Ushinbuy/PHD_Badge_2025/README.md

# PHD_Badge_2025
This repository contain hardware files of PHD Badge 2025
