Ushinbuy/PHD_Badge_2025/pcb/BOM/Bill of Materials-PHD_Badge_revС(Production).xlsx

Designator | Description/Value | PartNumber | Package | Quantity | Notes
A1 | Bluetooth, WiFi 802.11b/g/n Transceiver Module 2.4GHz PCB antenna SMD module | ESP32-WROOM-32E-N16 | 38-SMD Module, Exposed Pad | 1 | Аналог ESP32-WROOM-32E-N16R2
C1_A2, C1_A3, C1_A4, C1_A5, C1_A6, C1_A7, C1_A8, C1_A9, C1_A10, C1_A11, C2_A2, C2_A3, C2_A4, C2_A5, C2_A6, C2_A7, C2_A8, C2_A9, C2_A10, C2_A11, C15, C26 | Ceramic capacitor, 0805, 1u, ±10%, 25V, X7R, -55...+125°C, Capacitors SMD 0805, 1 uF, 25V, X7R, 0805 | CC0805KFX7R8BB105 | 0805 | 22
C11, C12, C14, C19, C21, C22, C29, C30, C31, C32, C33 | Capacitors SMD 0805, 100 nF, 50V, X7R, 0805, Ceramic capacitor, 0805, 0.1u, ±10%, 50V, X7R, -55...+125°C | CC0805JRX7R9BB104 | 0805 | 11
C13, C25 | Capacitors SMD 0805, 10 uF, 10V, X7R, 0805 | CC0805KKX7R6BB106 | 0805 | 2
C16 | Capacitors SMD 0805, 4.7 nF, 50V, NP0, 0805 | GRM2165C1H472JA01D | 0805 | 1
C17, C18, C23, C24, C27, C28 | Capacitors SMD 1206, 22 uF, 16V, X5R, 1206 | GRM31CR61C226KE15L | 1206 | 6
C20 | Capacitors SMD 0805, 470 pF, 50V, NP0, 0805 | CC0805JRNPO9BN471 | 0805 | 1
D1, D2 | DIODE, SCHOTTKY, 1A, 40V, SOD-123 | 1N5819HW | SOD-123 | 2
D3, D4 | Diode Schottky 40V 1A Surface Mount DO-214AC (SMA) | SS34 | DO-214AC (SMA) | 2
DA1 | 1A Standalone Linear Li-lon Battery Charger with Thermal | TP4056-42-SOP8-PP | eSOP-8 | 1
DA2 | 600mA CMOS L.D.O. Regulator | LM8805SF5-3.3 | SOT23-5 | 1
L1 | Power Inductors - SMD 22uH 2.9A 30% SMD LP | CDRH105RNP-220NC | SMD 10x10x5 | 1
LED1, LED2 | LED IR LED-SMD(3010) Right Angel | KPA-3010F3C | LED-SMD(3010), Right Angel | 2
Q1 | Electro-magnetic Sound Generator Component | HCS0905Z/1196 | HCS0905Z/1196 | 1
R1, R6, R7, R14, R29 | Resistors SMD 0805, 1 kOhm, 5%, 0805 | RC0805JR-071KL | 0805 | 5
R2, R5, R10 | Resistors SMD 0805, 1.2 kOhm, 1%, 0805 | RC0805FR-071K2L | 0805 | 3
R3 | Resistors SMD 1206, 0.2, ±1%, 1206 | RL1206FR-070R2L | 1206 | 1
R4, R22, R23, R24, R25, R26, R27, R28, R30 | Resistors SMD 0805, 10 kOhm, 5%, 0805 | RC0805JR-0710KL | 0805 | 9
R8, R9 | Resistors SMD 0805, 100 Ohm, 5%, 0805 | RC0805JR-07100RL | 0805 | 2
R12, R16 | Resistors SMD 0805, 5.1 kOhm, 1%, 0805 | RC0805FR-075K1L | 0805 | 2
R13, R17 | Resistors SMD 0805, 0 Ohm, 5%, 0805 | RC0805JR-070RL | 0805 | 2
R15 | Resistors SMD 0805, 1 MOhm, 5%, 0805 | RC0805JR-071ML | 0805 | 1
R18 | Resistor thick-film, 0805, 330k, ±1%, 0.063W, -55...+125°C | RC0805FR-07330KL | 0805 | 1
R19 | Resistor thick-film, 0805, 510k, ±1%, 0.063W, -55...+125°C | RC0805FR-07510KL | 0805 | 1
R20 | Resistors SMD 0805, 16 kOhm, 1%, 0805 | RC0805FR-0716KL | 0805 | 1
R21 | Resistors SMD 0805, 2.2 kOhm, 1%, 0805 | RC0805FR-072K2L | 0805 | 1
SW1 | Tactile Switch SPST-NO Top Actuated Surface Mount | MSK-12C02 | MSK-12C02 | 1
SW2, SW3, SW4 | SMT Button 3x6 Tact Switch Series | IT-1188E | IT-1188E SMD 6x3x3.5 | 3
U1 | IC 8BIT SHIFT REG 3ST-OUT 16SOIC | CH340C | 16-SOIC (0.154", 3.90mm Width) | 1
U2 | IR Remote Receiver 38 kHz 4-Pin | TSOP75238 | SMD 6.8x3.0x3.2 | 1
U3 | High Efficiency 1.2MHz 2A Step Up Converter | MT3608 | SOT23-6 | 1
VD1_A2, VD1_A3, VD1_A4, VD1_A5, VD1_A6, VD1_A7, VD1_A8, VD1_A9, VD1_A10, VD1_A11, VD2_A2, VD2_A3, VD2_A4, VD2_A5, VD2_A6, VD2_A7, VD2_A8, VD2_A9, VD2_A10, VD2_A11, VD3_A2, VD3_A3, VD3_A4, VD3_A5, VD3_A6, VD3_A7, VD3_A8, VD3_A9, VD3_A10, VD3_A11, VD4_A2, VD4_A3, VD4_A4, VD4_A5, VD4_A6, VD4_A7, VD4_A8, VD4_A9, VD4_A10, VD4_A11, VD5_A2, VD5_A3, VD5_A4, VD5_A5, VD5_A6, VD5_A7, VD5_A8, VD5_A9, VD5_A10, VD5_A11, VD6_A2, VD6_A3, VD6_A4, VD6_A5, VD6_A6, VD6_A7, VD6_A8, VD6_A9, VD6_A10, VD6_A11, VD7_A2, VD7_A3, VD7_A4, VD7_A5, VD7_A6, VD7_A7, VD7_A8, VD7_A9, VD7_A10, VD7_A11, VD8_A2, VD8_A3, VD8_A4, VD8_A5, VD8_A6, VD8_A7, VD8_A8, VD8_A9, VD8_A10, VD8_A11, VD9_A2, VD9_A3, VD9_A4, VD9_A5, VD9_A6, VD9_A7, VD9_A8, VD9_A9, VD9_A10, VD9_A11, VD10_A2, VD10_A3, VD10_A4, VD10_A5, VD10_A6, VD10_A7, VD10_A8, VD10_A9, VD10_A10, VD10_A11 | Top SMD Type 0.2Watt Power tegrated light source Intelligent control LED 3.5x3.7x0.95mm | WS2812B-Mini | LED 3535 | 100
VD11 | LED GREEN CLEAR 0603 SMD | KPA-3010CGCK | LED-SMD(3010), Right Angel | 1
VD12 | LED RED CLEAR 0603 SMD | KPA-3010SURC | LED-SMD(3010), Right Angel | 1
VT1, VT2, VT3, VT5, VT6 | MOSFET N-channel, SOT23 | BSS138 | SOT23-3 | 5
VT4 | MOSFET P-channel, SOT23 | AO3401 | SOT23-3 | 1
X1 | Li-Pol Accumulator, JST-PHR-03 plug,BR603448D-PCM-NTC-LD, size 50.5x34.5x6.2 | BR603448D-PCM-NTC-LD | 50.5x34.5x6.2 | 1
X6 | USB type-C connector | 1054500101 | 1054500101 | 1
X7 | A range shrouded headers for the JST PH series of low-profile 2.0mm pitch wire-to-board connectors. | S3B-PH-SM4-TB | JST PH, 2.0mm, 3 pin, THD | 1
