Ushinbuy/PHD_Badge_2025/3d/Front frame.stl

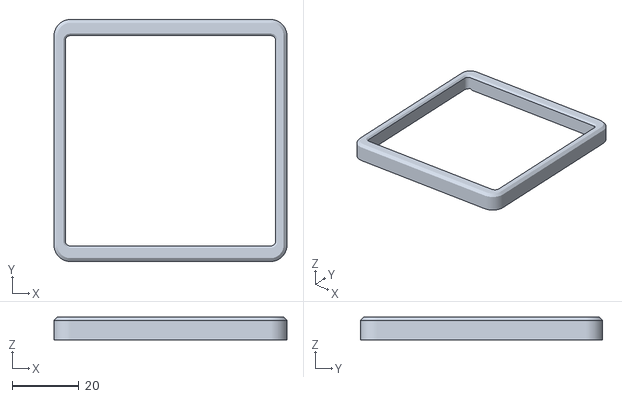
[picture p1: CAD file, 2025-04-30]
3d/Front frame.stl
70.0 x 72.8 x 6.84
