Ushinbuy/PHD_Badge_2025/3d/Thick FrameFrame.stl

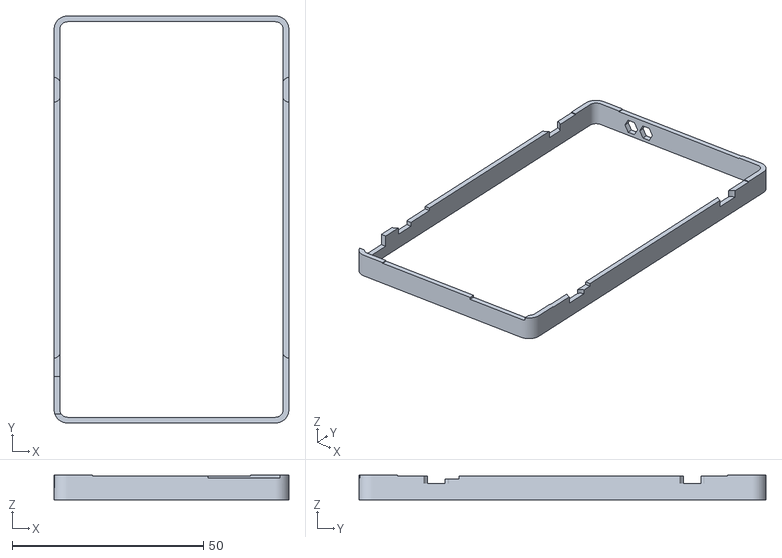
[picture p2: CAD file, 2025-04-30]
3d/Thick FrameFrame.stl
61.4 x 106.4 x 6.50
