Ushinbuy/PHD_Badge_2025/3d/Table_for_Leds.stl

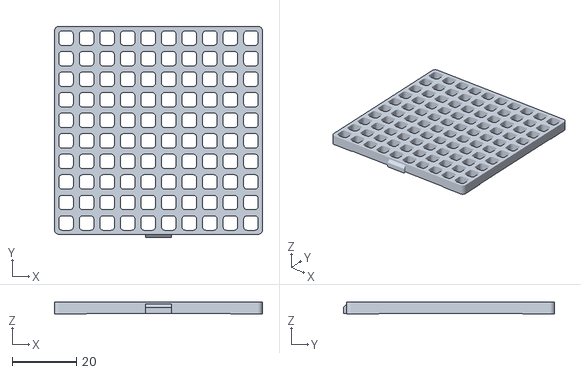
[picture p3: CAD file, 2025-04-30]
3d/Table_for_Leds.stl
64.8 x 65.9 x 3.84
