Ushinbuy/PHD_Badge_2025/3d/Back Frame upd.stl

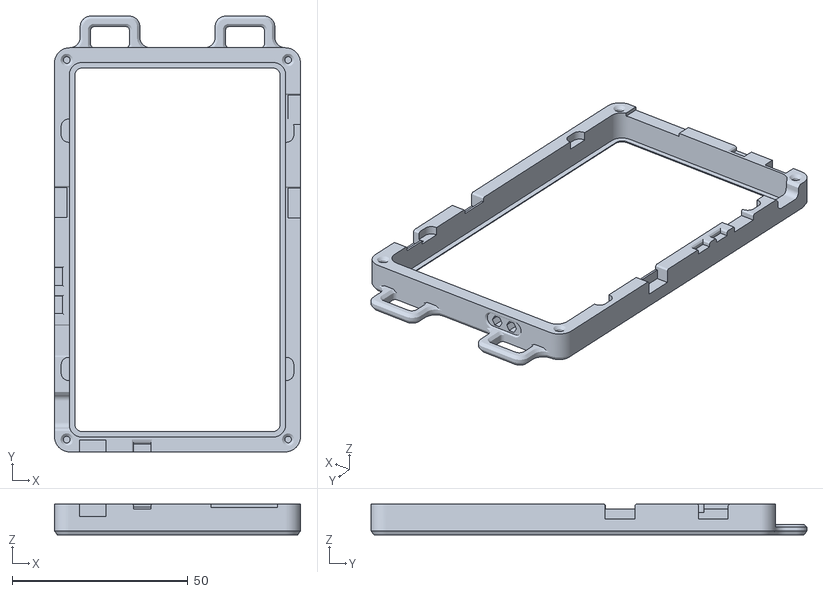
[picture p4: CAD file, 2025-04-30]
3d/Back Frame upd.stl
70.0 x 124.0 x 8.80
