Ushinbuy/PHD_Badge_2025/pcb/Schematic PDF/PHD_Badge_revС.PDF

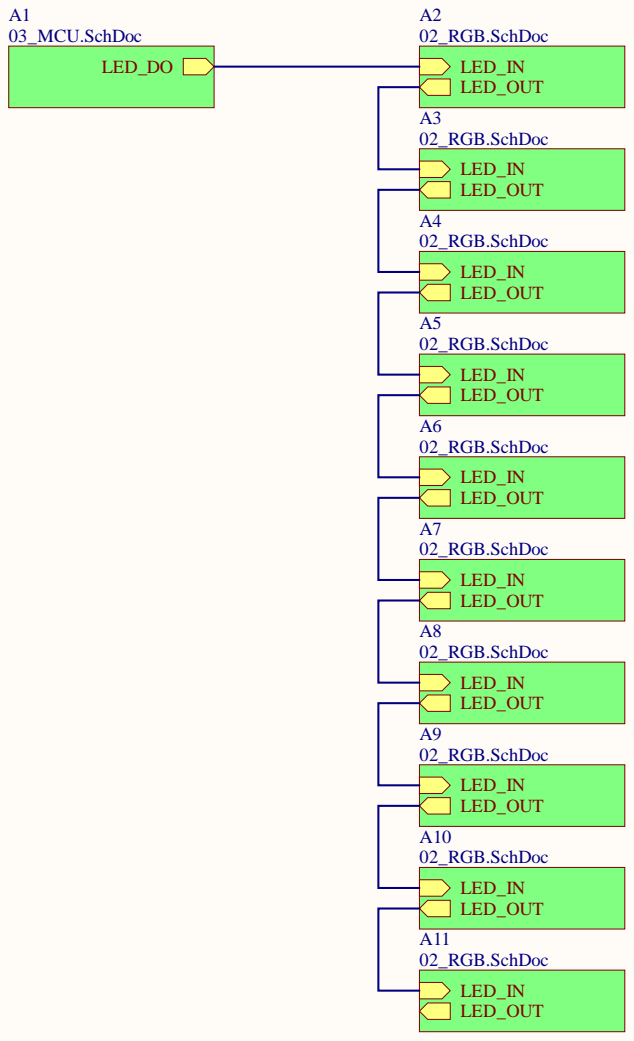
[picture p5: page 1]

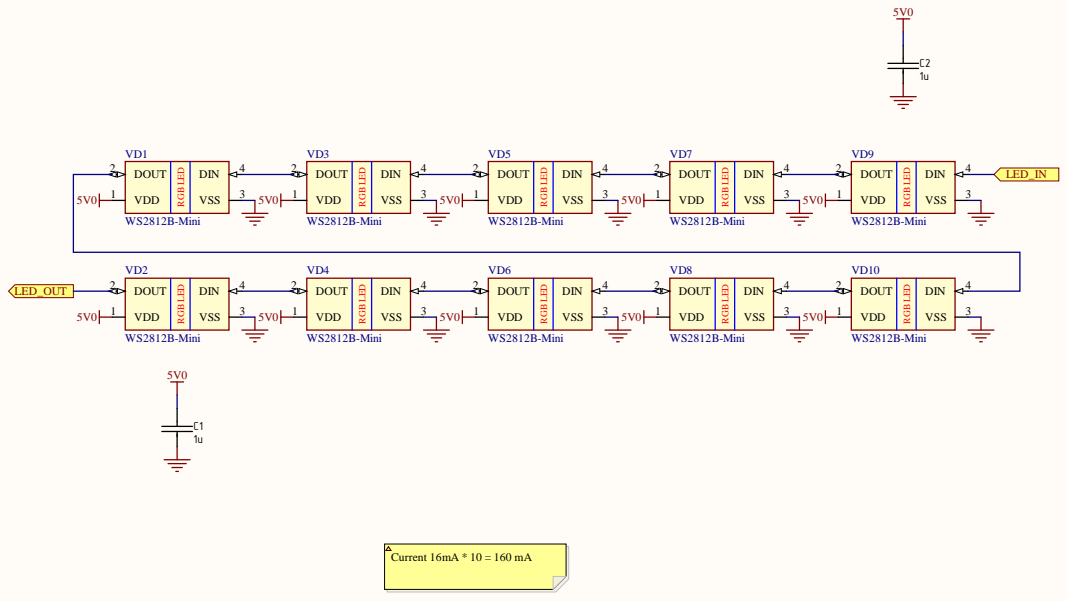
[picture p6: page 2]

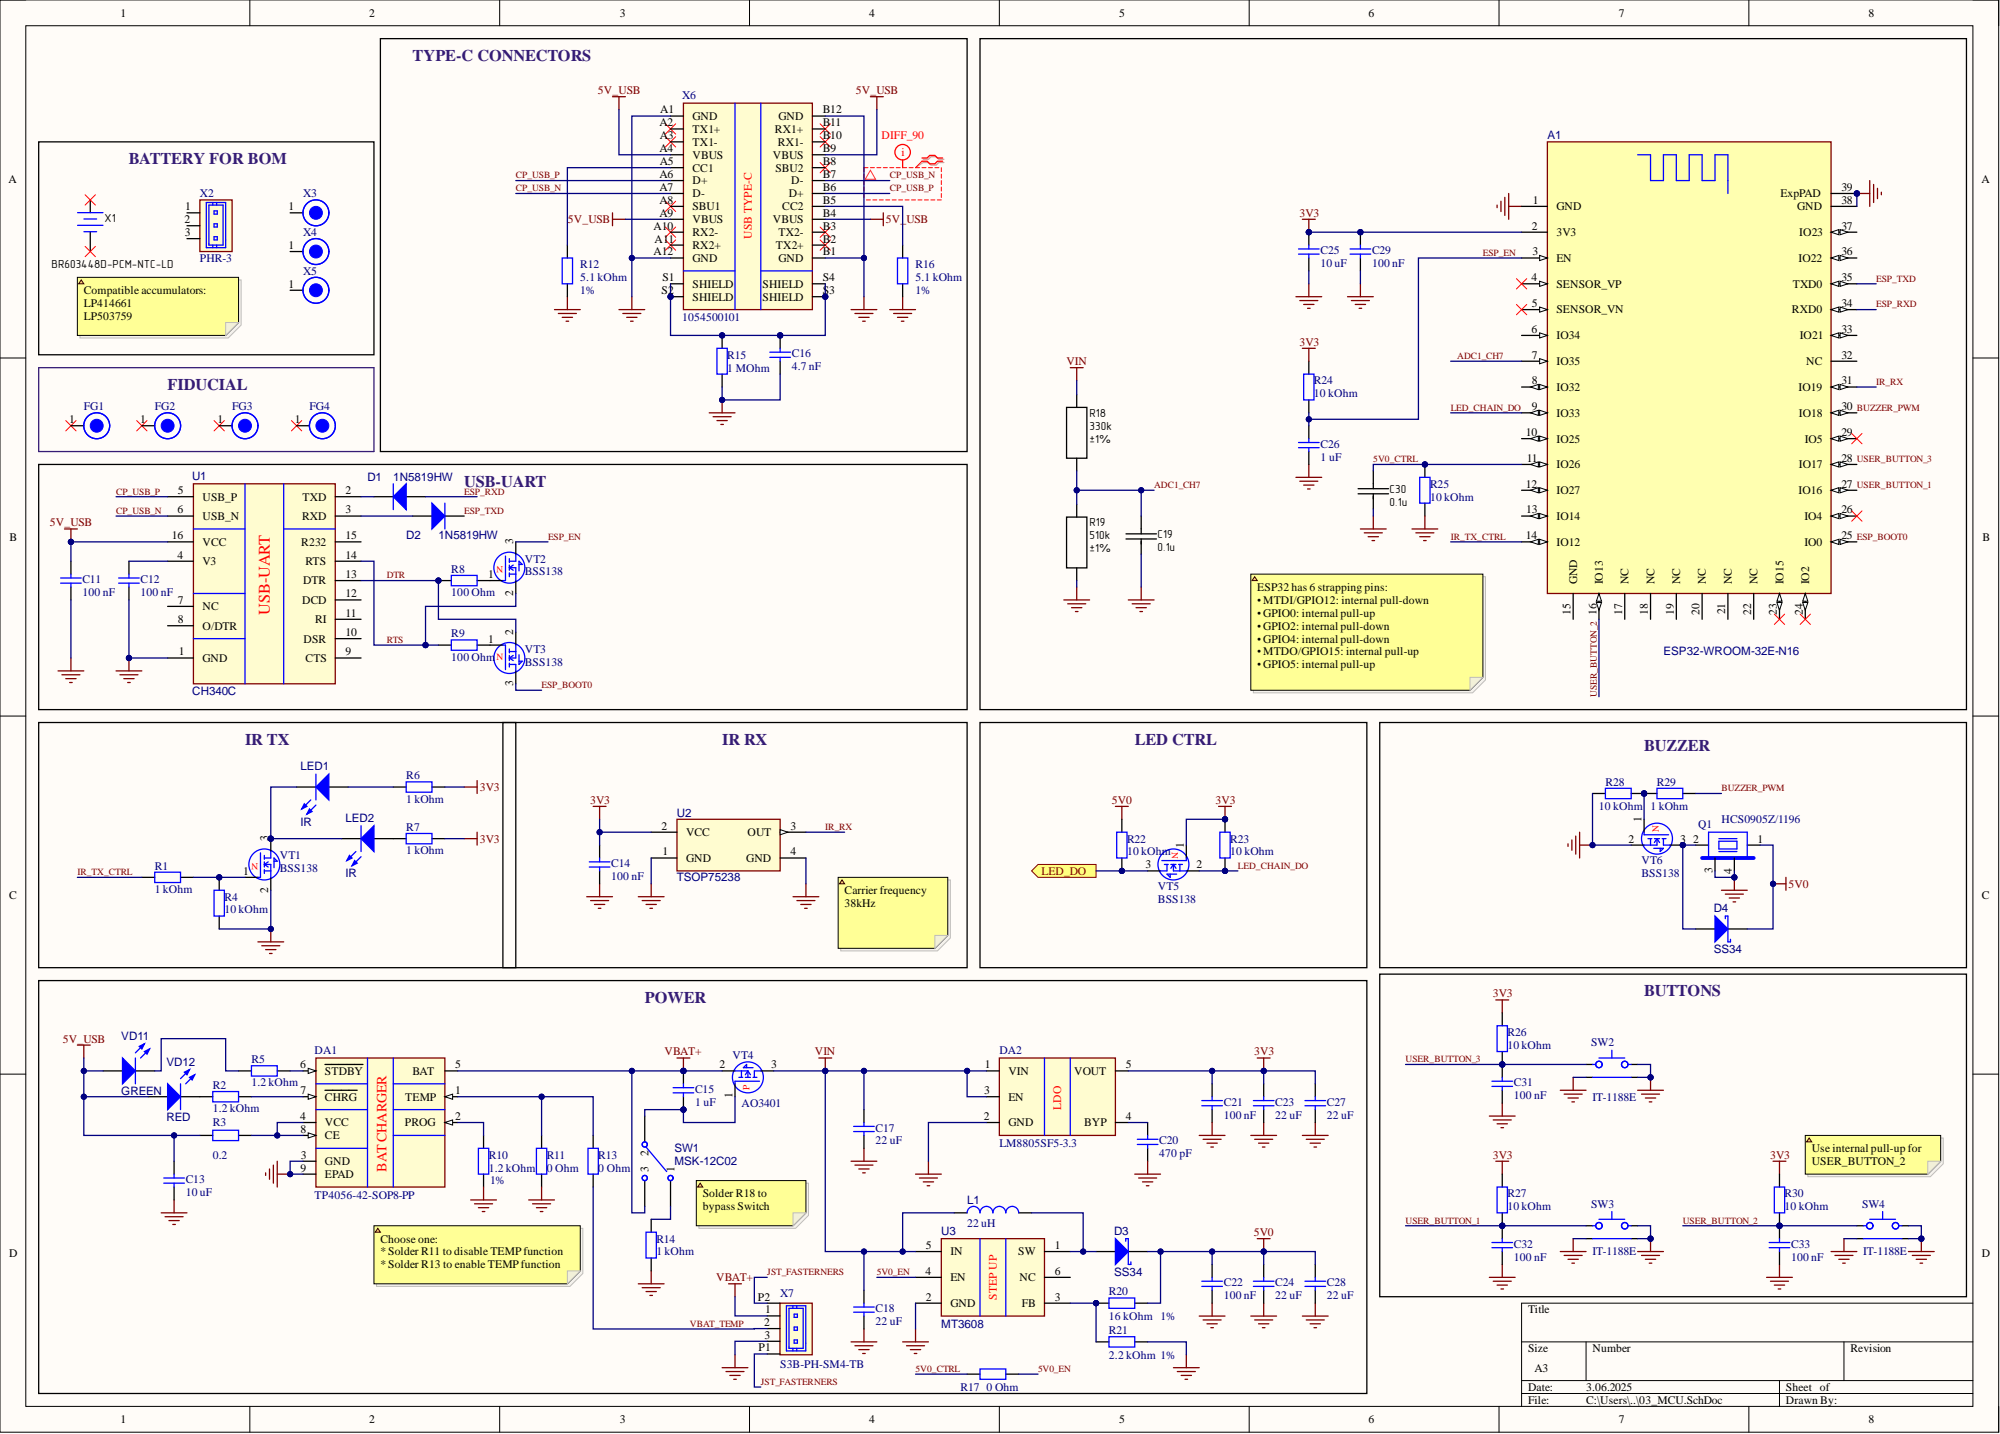
[picture p7: page 3]

D+ A6 | CP_USB_N CP_USB_P

SBU1 A8

ESP32 has 6 strapping pins:
• MTDI/GPIO12: internal pull-down
• GPIO0: internal pull-up
• GPIO2: internal pull-down
• GPIO4: internal pull-down
• MTDO/GPIO15: internal pull-up
• GPIO5: internal pull-up

Use internal pull-up for
USER_BUTTON_2

Choose one:
* Solder R11 to disable TEMP function
* Solder R13 to enable TEMP function
