Ushinbuy/PHD_Badge_2025/pcb/Assembly/Asembly.PDF

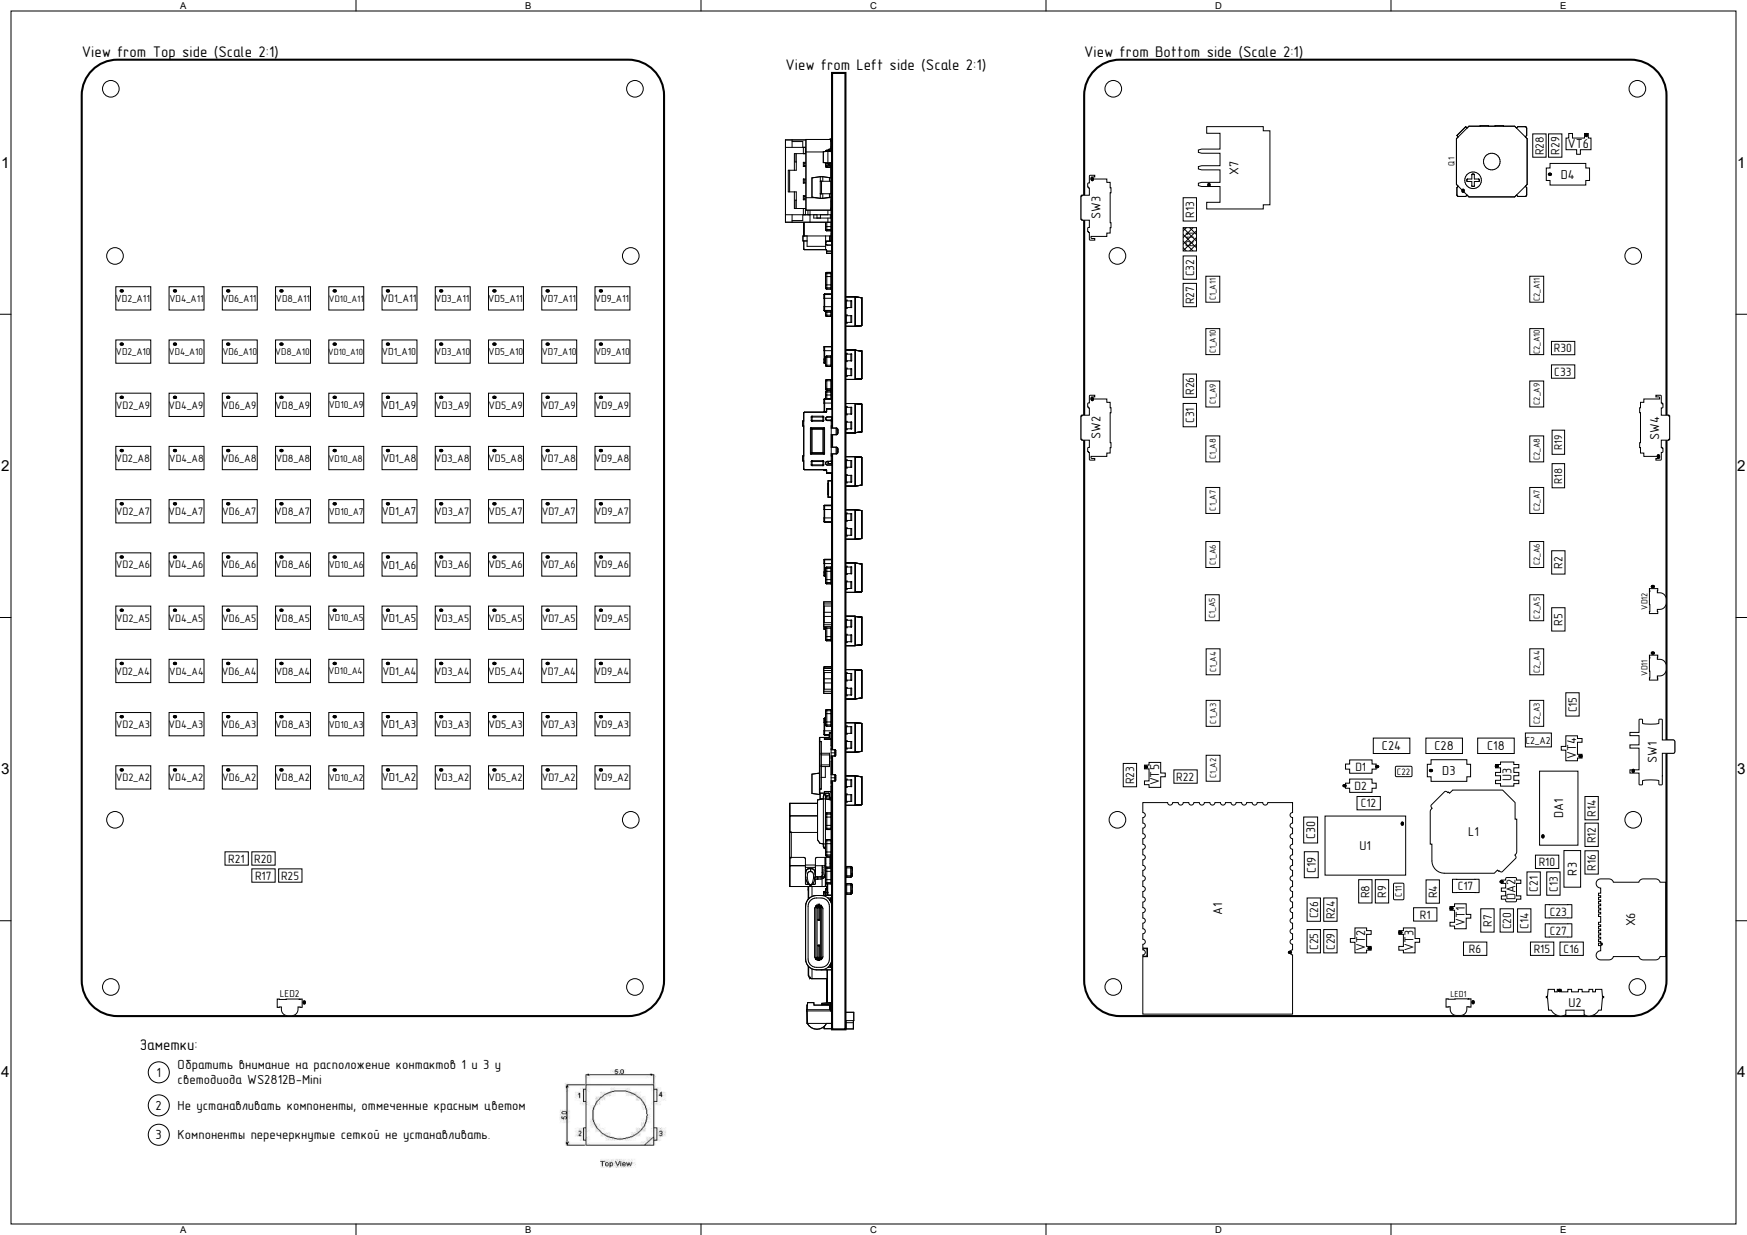
[picture p8: page 1]

View from Top side (Scale 2:1)

View from Bottom side (Scale 2:1)

View from Left side (Scale 2:1)

R21 | R20
R17 | R25

Заметки:
Обратить внимание на расположение контактов 1 и 3 у
светодиода WS2812B-Mini
2 Не устанавливать компоненты, отмеченные красным цветом

3 Компоненты перечеркнутые сеткой не устанавливать.
