Ushinbuy/PHD_Badge_2025/(commit log)

2025-04-30 Add 3D models
    [Back Frame upd.stl, Front frame.stl, Table_for_Leds.stl, Thick FrameFrame.stl]
2025-06-22 Move 3d models in 3d folder.
    [Back Frame upd.stl, Front frame.stl, Table_for_Leds.stl, Thick FrameFrame.stl]
2025-06-22 Add pcb files.
    [Bill of Materials-PHD_Badge_revС(Production).xlsx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]
